Perkos73/pcb-psu-led/pcb-psu-led.kicad_sch

## KiCad design pcb-psu-led.kicad_sch (2026-07-17)

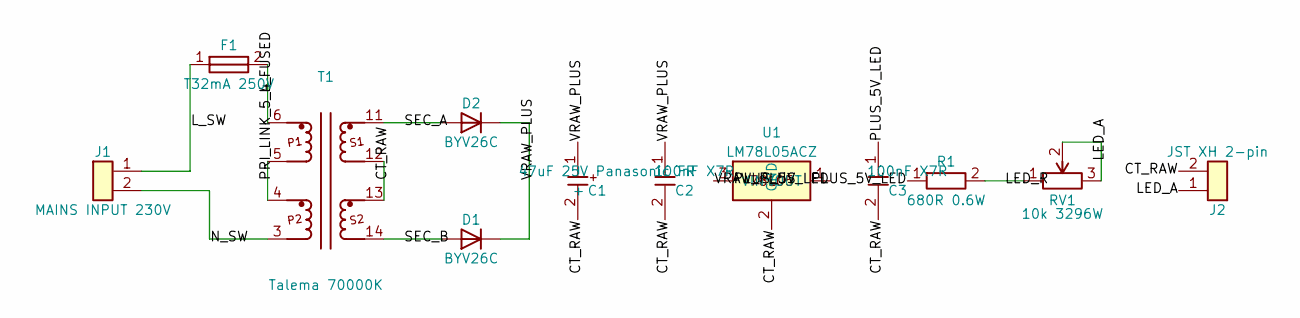
[picture p1: schematic pcb-psu-led.kicad_sch]

Parts:
C1: 47uF 25V Panasonic FR; CP_Radial_D6.3mm_P2.50mm; MPN EEU-FR1E470
C2, C3: 100nF X7R; C_Disc_D5.0mm_W2.5mm_P5.00mm; MPN TBD
D1, D2: BYV26C; D_DO-15_P12.70mm_Horizontal; MPN BYV26C
F1: T32mA 250V; Fuseholder_Cylinder-5x20mm_Schurter_FUP_0031.2510_Horizonta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; MPN TBD
J1: MAINS INPUT 230V; TerminalBlock_Phoenix_MKDS-1,5-2-5.08_1x02_P5.08mm_Horizont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; MPN TBD
J2: JST XH 2-pin; JST_XH_S2B-XH-A_1x02_P2.50mm_Horizontal; MPN TBD
R1: 680R 0.6W; R_Axial_DIN0309_L9.0mm_D3.2mm_P12.70mm_Horizontal; MPN PR02000206800JA100
RV1: 10k 3296W; Potentiometer_Bourns_3296W_Vertical; MPN 3296W-1-103LF
T1: Talema 70000K; Talema_70000K; MPN 70000K
U1: LM78L05ACZ; TO-92_Wide; MPN LM78L05ACZ

Connections:
CT_RAW: C1.2 (-), C2.2, C3.2, J2.2, T1.12 (S1_END), T1.13 (S2_START), U1.2 (GND)
LED_A: J2.1, RV1.2, RV1.3
LED_R: R1.2, RV1.1
L_FUSED: F1.2, T1.6 (P1_START)
L_SW: F1.1, J1.1
N_SW: J1.2, T1.3 (P2_END)
PLUS_5V_LED: C3.1, R1.1, U1.1 (VOUT)
PRI_LINK_5_4: T1.4 (P2_START), T1.5 (P1_END)
SEC_A: D2.2 (A), T1.11 (S1_START)
SEC_B: D1.2 (A), T1.14 (S2_END)
VRAW_PLUS: C1.1 (+), C2.1, D1.1 (K), D2.1 (K), U1.3 (VIN)
