Perkos73/pcb-psu-led/(commit log)

2026-07-14 Automatyczna aktualizacja raportow KiCad
2026-07-14 Save KiCad smoke-test result
2026-07-14 Add PCB PSU LED stage-1 schematic and ERC report
    [pcb-psu-led.kicad_sch]
2026-07-14 Update KiCad validation reports
2026-07-15 Add initial KiCad project file
2026-07-15 Add initial KiCad schematic
    [pcb-psu-led.kicad_sch]
2026-07-15 Add KiCad 10.0.4 validation workflow
2026-07-15 Fix KiCad validation workflow
2026-07-15 Fix writable KiCad environment for schematic syntax check
2026-07-15 Harden KiCad input checks and ERC execution
2026-07-15 Replace KiCad validation workflow with diagnostic release
2026-07-15 Rename grid-fixed schematic to project schematic
2026-07-15 Replace CI with writable-copy KiCad validation
2026-07-15 Add J1 and Talema primary series wiring
    [pcb-psu-led.kicad_sch]
2026-07-15 Fix local connector symbol syntax
2026-07-15 Migrate J1 to local project symbol
    [pcb-psu-led.kicad_sch]
2026-07-15 Mirror J1 to restore pin 1 L and pin 2 N
    [pcb-psu-led.kicad_sch]
2026-07-15 Synchronize J1 schematic copy with project library
2026-07-15 Remove J1 mirror and canonicalize pin order
    [pcb-psu-led.kicad_sch]
2026-07-15 ECAD-08: normalize J1 pin_names hide syntax
    [pcb-psu-led.kicad_sch]
2026-07-15 CI-DIAG-01: add parse-normalization probe
2026-07-15 ECAD-09: normalize J1 Datasheet field
    [pcb-psu-led.kicad_sch]
2026-07-15 CI-CLEAN-01: remove completed normalization probe
2026-07-15 ECAD-10: add reservoir capacitor C1
    [pcb-psu-led.kicad_sch]
2026-07-15 ECAD-11: add LM78L05ACZ regulator U1
    [pcb-psu-led.kicad_sch]
2026-07-16 ECAD-12: correct Talema_70000K pad drill to 1.5 mm per datasheet
2026-07-16 ECAD-13: remove last legacy tilde placeholder from J1 instance
    [pcb-psu-led.kicad_sch]
2026-07-16 ECAD-14: add primary fuse F1 rated T32 mA per Talema datasheet
    [pcb-psu-led.kicad_sch]
2026-07-16 ECAD-15: add U1 input and output bypass capacitors C2 and C3
    [pcb-psu-led.kicad_sch]
2026-07-16 PCB2-ECAD-04R1: register standard footprint libraries
2026-07-16 ECAD-16: add LED branch R1, RV1 and output connector J2
    [pcb-psu-led.kicad_sch]
2026-07-16 PCB2-PCB-03R1: synchronize board with schematic
    [pcb-psu-led.kicad_pcb]
2026-07-16 MAIN-REVERT-02: remove accidental PCB2 board file
    [pcb-psu-led.kicad_pcb]
2026-07-16 CI-02: add one-shot stock footprint harvester
2026-07-16 CI-02: add one-shot stock footprint name harvester
2026-07-16 CI-03: add one-shot footprint importer
2026-07-17 ECAD-17: import stock footprints from frozen KiCad 10.0.4 image
2026-07-17 ECAD-18: import Phoenix MKDS terminal block footprint for J1
2026-07-17 ECAD-19: assign footprints to all twelve schematic instances
2026-07-17 ECAD-19b: actually assign footprints to schematic instances
    [pcb-psu-led.kicad_sch]
2026-07-17 DOC-08: ignore KiCad local state files
2026-07-18 ECAD-20: define MAINS/SELV net classes and 6 mm barrier DRC rules
2026-07-18 CI-04: add BOM footprint gate and conditional DRC to CI
2026-07-18 DOC-09: add verified MPN and footprint research to platform spec
2026-07-18 CI-05: remove one-shot footprint harvest and import workflows
